basilhussain/rx8-wipers/README.md

This project is an upgrade to the Mazda RX-8's windshield / windscreen wiper system that adds speed-sensitive functionality to the intermittent operation mode.

See the project write-up at https://www.stasisleak.uk/rx8/wipers/ for more information.
