basilhussain/rx8-wipers/hardware/layout.png

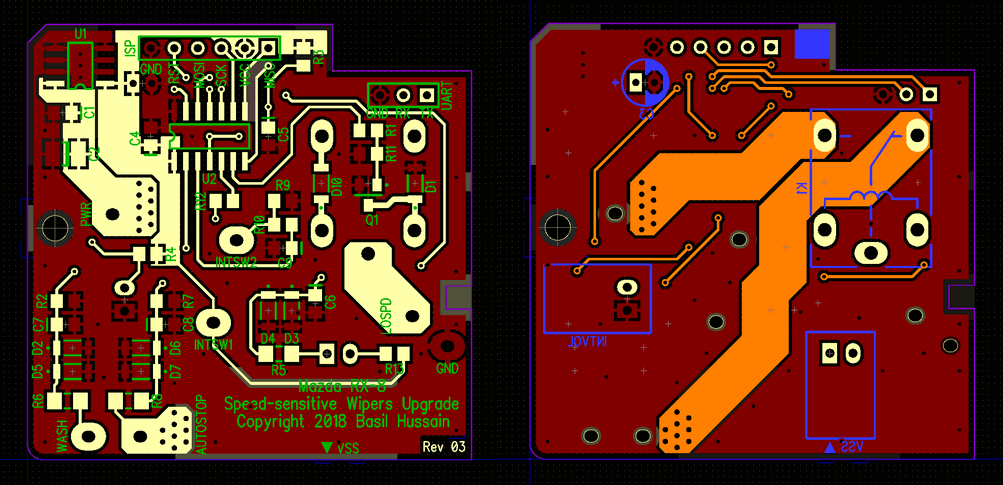
hardware/layout.png
