basilhussain/rx8-wipers/hardware/schematic.pdf

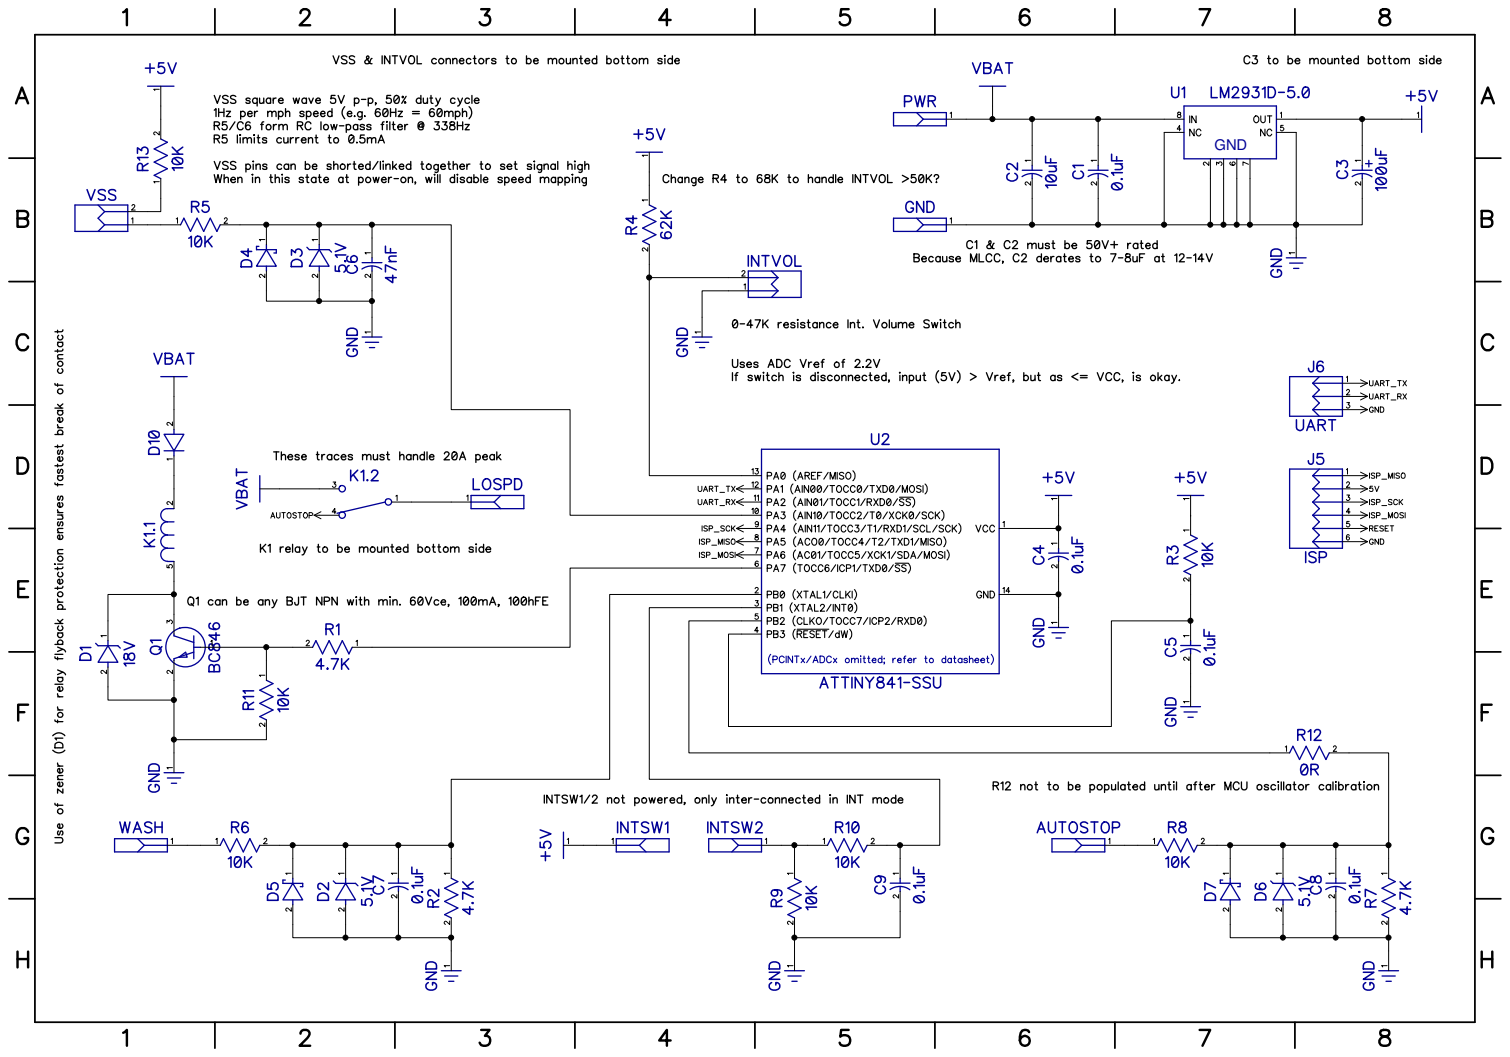
[picture p2: page 1]
GND
