basilhussain/rx8-wipers/(list of files, drawings)

Other design files:
hardware/rx8-wipers-rev-03.dch
hardware/rx8-wipers-rev-03.dip
