basilhussain/rx8-wipers/(commit log)

2020-09-10 Added firmware and hardware files
    [bom.csv, rx8-wipers-rev-03.dch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]
2020-09-11 Added VSS wiring parts to hardware BOM
    [bom.csv]
2021-04-17 Correct PCB copper thickness spec; add PCB layout image
